fer662/tero-toolhead/exports/cfd/large/walls.stl

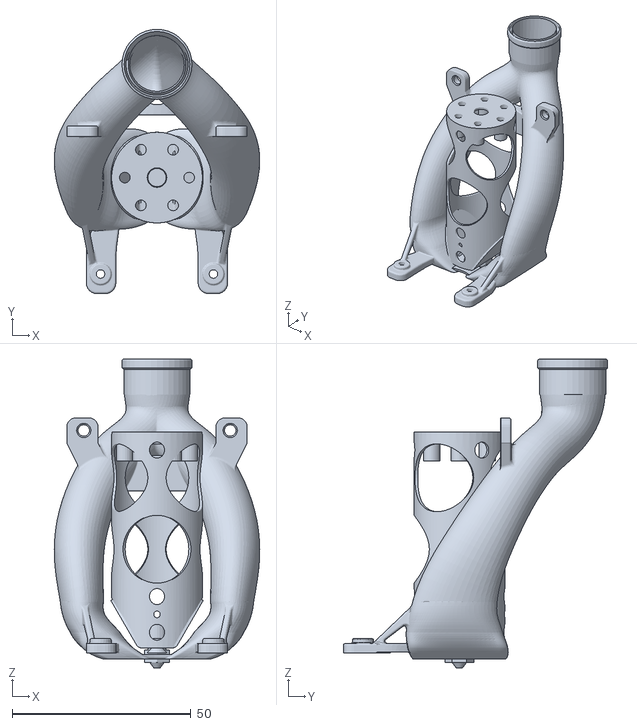
[picture p5: CAD file, 2026-11-13]
exports/cfd/large/walls.stl
57.5 x 74.0 x 86.5
