fer662/tero-toolhead/exports/cfd/small/walls.stl

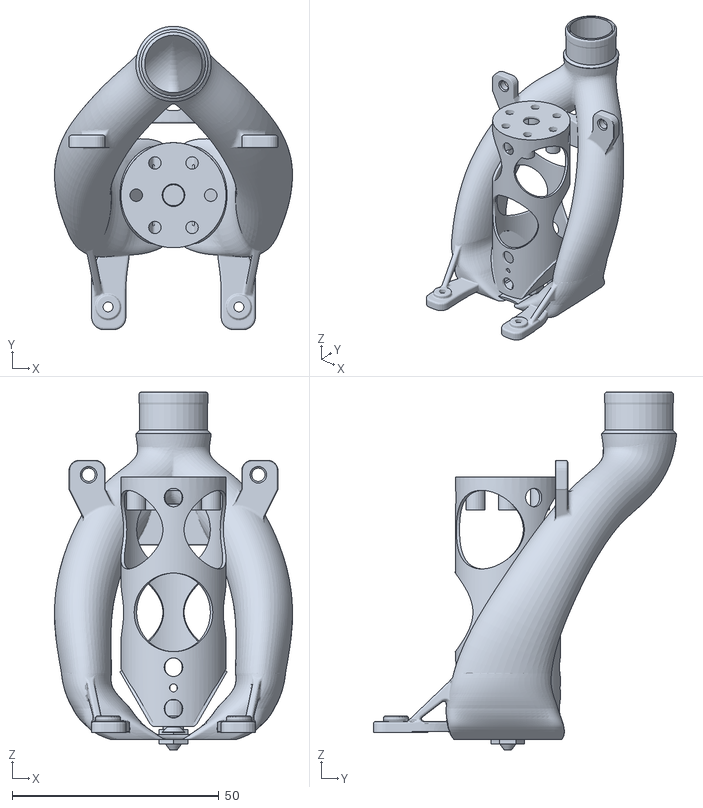
[picture p6: CAD file, 2026-11-13]
exports/cfd/small/walls.stl
57.5 x 73.3 x 86.5
