fer662/tero-toolhead/exports/stl/duct-small.stl

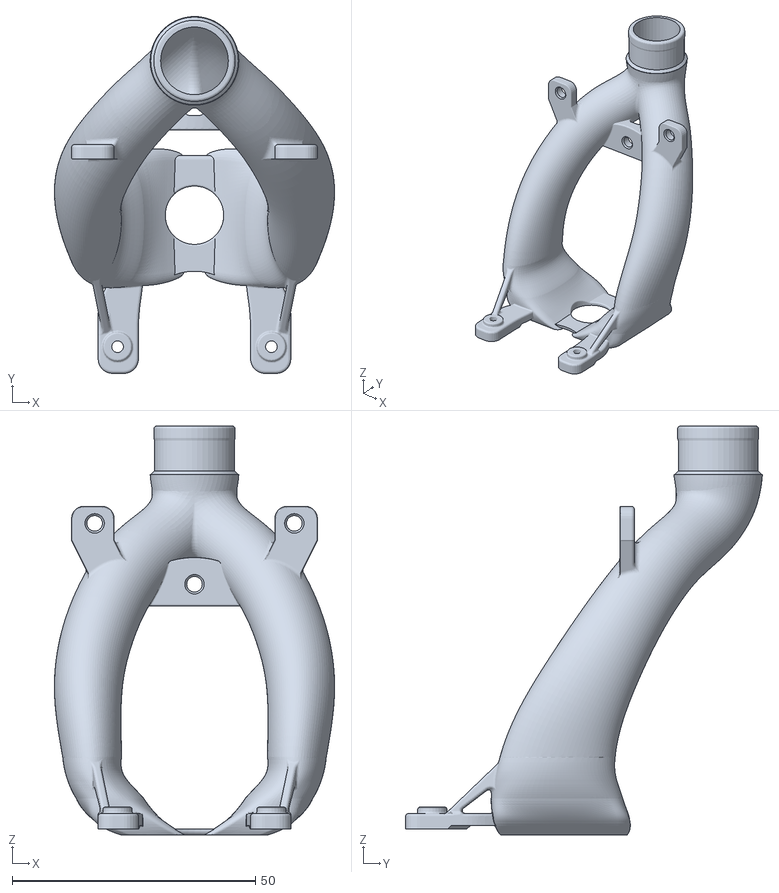
[picture p7: CAD file, 2026-11-13]
exports/stl/duct-small.stl
57.5 x 73.3 x 84.0
