fer662/tero-toolhead/exports/stl/monolith/core.stl

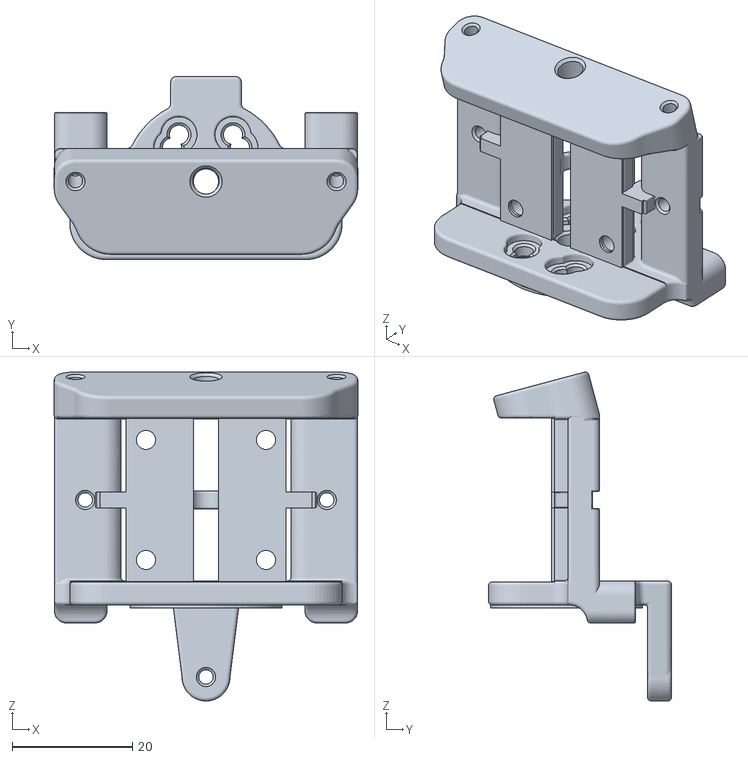
[picture p8: CAD file, 2026-11-13]
exports/stl/monolith/core.stl
50.6 x 30.5 x 54.8
