fer662/tero-toolhead/exports/stl/voron/core.stl

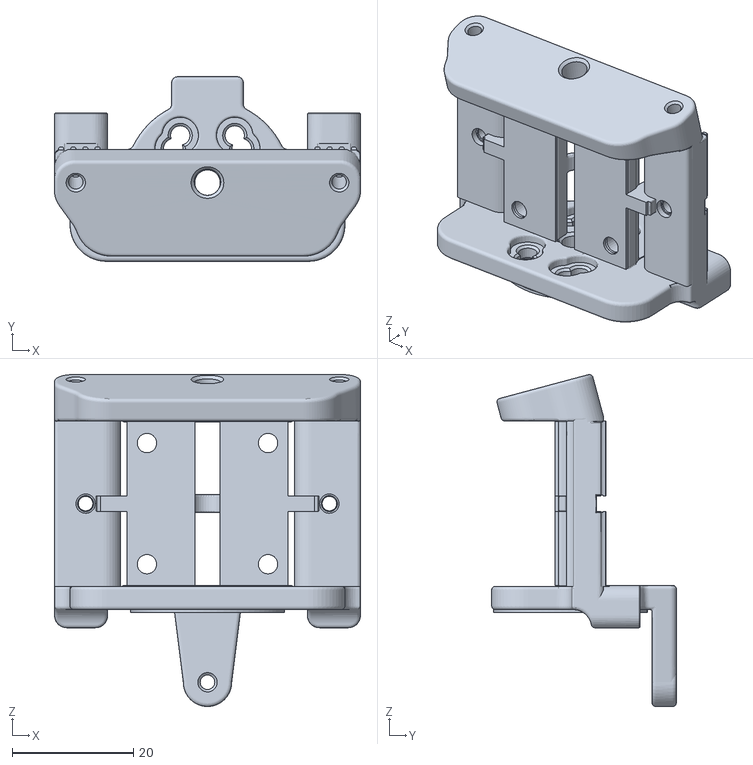
[picture p9: CAD file, 2026-11-13]
exports/stl/voron/core.stl
50.6 x 30.5 x 54.8
