fer662/tero-toolhead/exports/cfd/large/farfield.stl

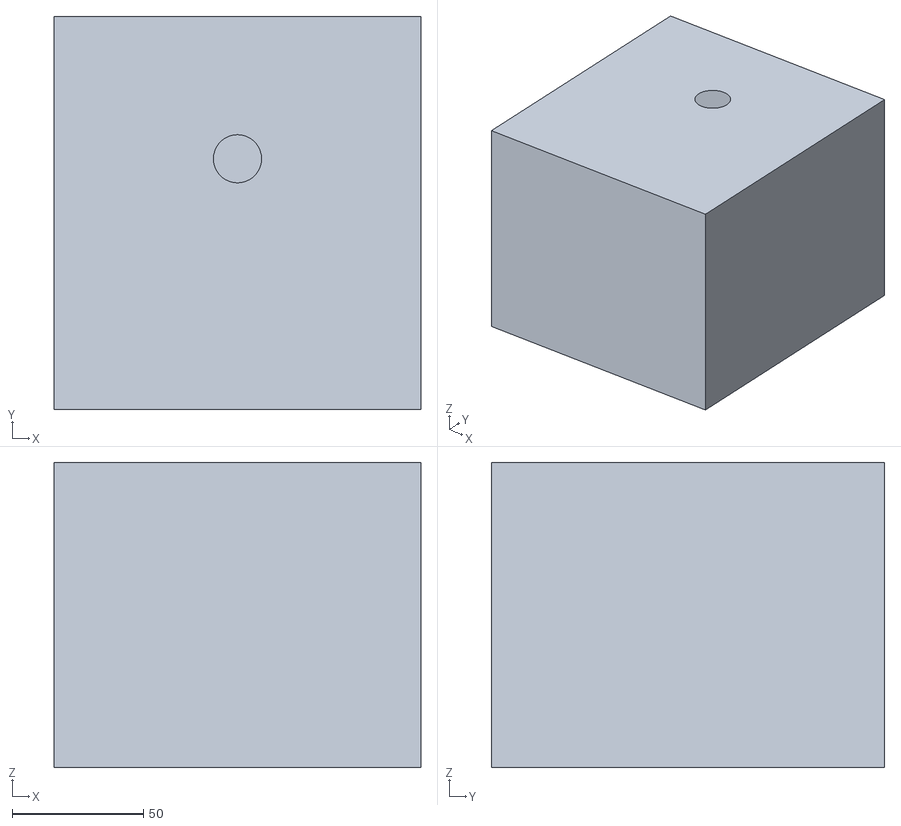
[picture p10: CAD file, 2026-11-07]
exports/cfd/large/farfield.stl
140.0 x 150.0 x 116.5
