fer662/tero-toolhead/exports/cfd/small/inlet.stl

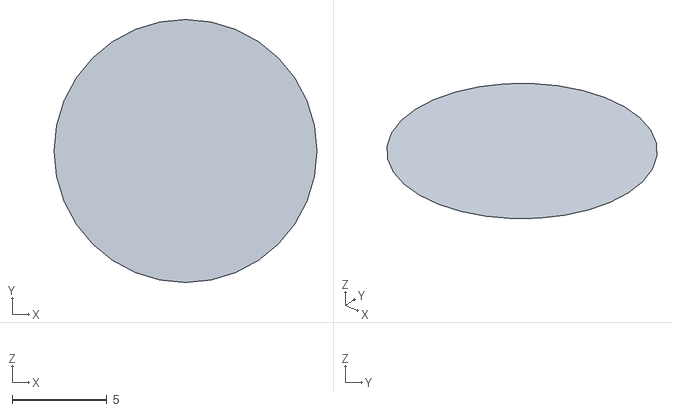
[picture p11: CAD file, 2026-11-07]
exports/cfd/small/inlet.stl
13.9 x 13.9 x 0
