fer662/tero-toolhead/exports/stl/duct-large.stl

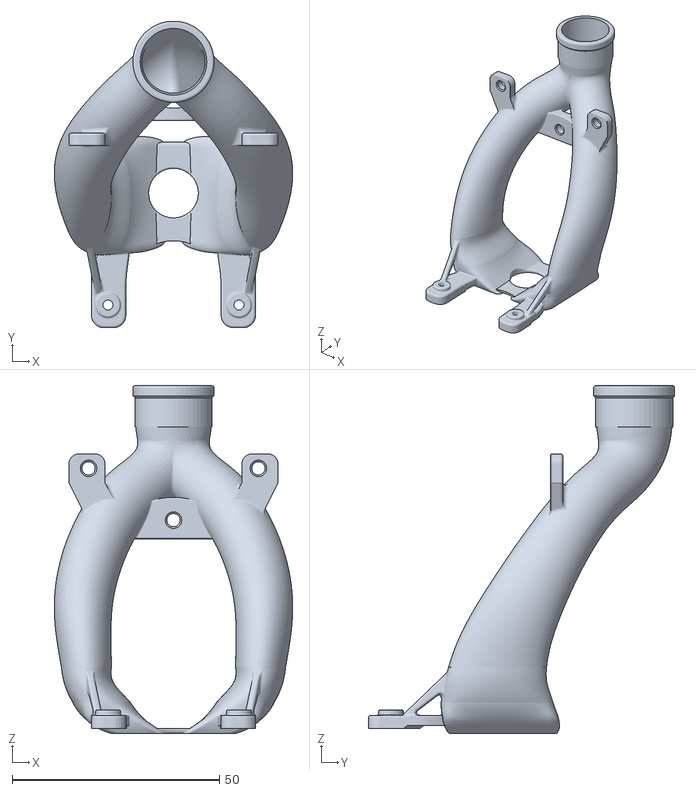
[picture p12: CAD file, 2026-11-13]
exports/stl/duct-large.stl
57.5 x 74.0 x 84.0
