fer662/tero-toolhead/exports/stl/monolith/clips-both.stl

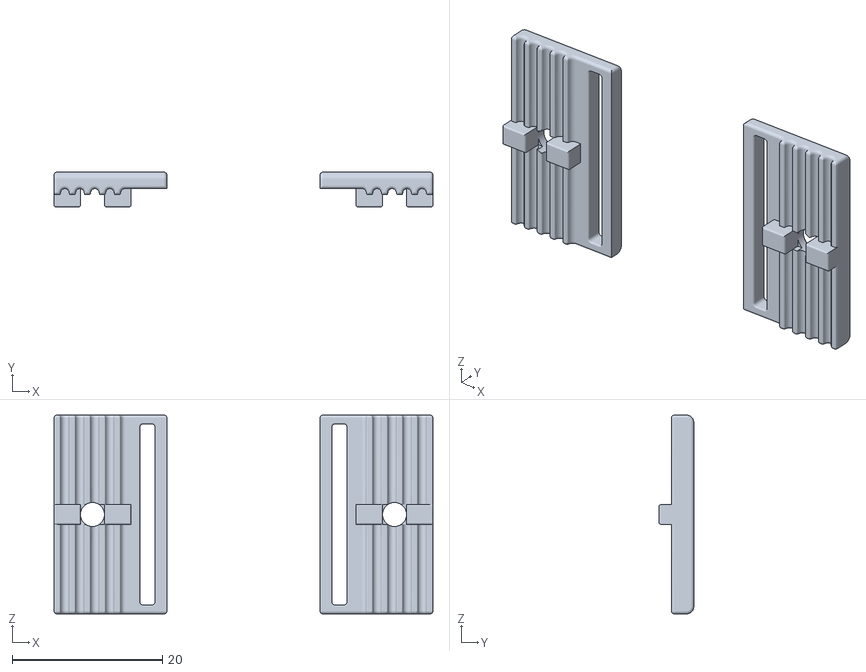
[picture p13: CAD file, 2026-11-08]
exports/stl/monolith/clips-both.stl
50.5 x 4.63 x 26.5
