fer662/tero-toolhead/exports/stl/voron/clips-both.stl

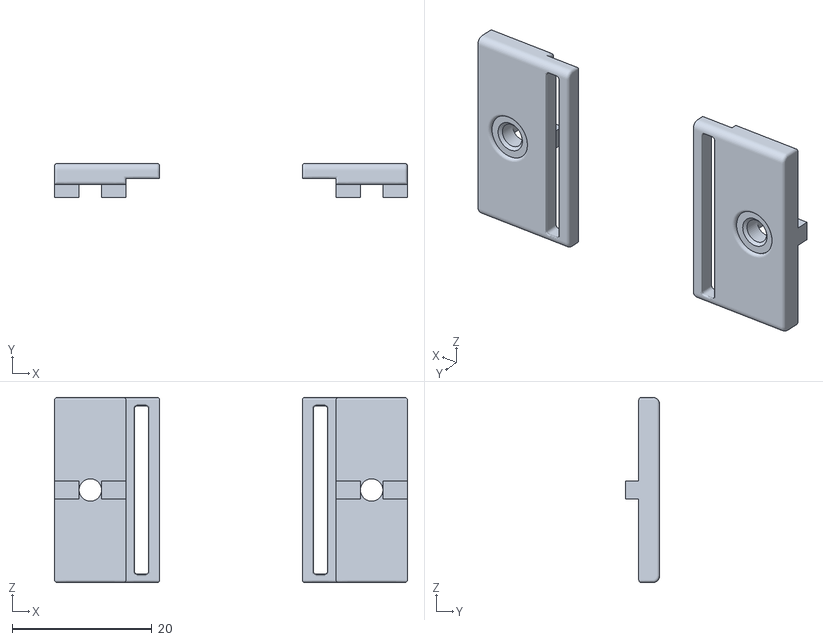
[picture p14: CAD file, 2026-11-09]
exports/stl/voron/clips-both.stl
50.5 x 4.92 x 26.5
