fer662/tero-toolhead/exports/cfd/large/inlet.stl

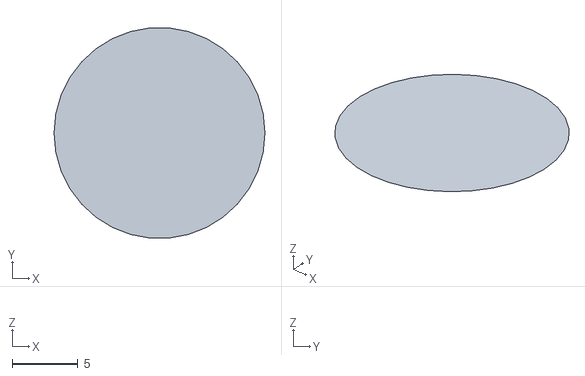
[picture p15: CAD file, 2026-11-07]
exports/cfd/large/inlet.stl
16.1 x 16.0 x 0
