fer662/tero-toolhead/(list of files, cad)

Other CAD files:
exports/cfd/small/farfield.stl
cad/toolhead.f3d
