fer662/tero-toolhead/(commit log)

2026-11-04 initial commit at v1.0-RC8
    [clip-left.stl, clip-right.stl, core.stl, duct-large.stl, duct-small.stl, farfield.stl, inlet.stl, toolhead.f3d]
2026-11-04 removed overhanging part of core that apparently wasn't doing any work
    [clip-right.stl, core.stl, toolhead.f3d]
2026-11-06 chamfer on top and bottom of hotend mounting point 2mm deeper sherpa mini mount holes chamfer on the beacon mounting point
    [clip-right.stl, core.stl, duct-large.stl, duct-small.stl, toolhead.f3d, walls.stl]
2026-11-07 increased depth of side duct mounting holes stronger beacon bracing
    [clip-right.stl, core.stl, duct-large.stl, duct-small.stl, toolhead.f3d, walls.stl]
2026-11-07 added loop around the PTFE tube so it doesn't move around reworked cad to improve timeline. no longer uses any base features for the toolhead parts clips export together
    [clip-left.stl, clip-right.stl, clips-both.stl, core.stl, duct-large.stl, duct-small.stl, farfield.stl, inlet.stl]
2026-11-08 Added belt slack management to the clips Updated screenshots
    [clips-both.stl, core.stl, duct-large.stl, duct-small.stl, toolhead.f3d, walls.stl]
2026-11-08 supporting voron belt path
    [clips-both.stl, core.stl, duct-large.stl, duct-small.stl, toolhead.f3d, walls.stl]
2026-11-09 made room to fit a socket for the nozzle adjusted duct exits
    [core.stl, duct-large.stl, duct-small.stl, toolhead.f3d, walls.stl]
2026-11-09 removed teeth on the back of core for voron belt path
    [core.stl, duct-large.stl, duct-small.stl, toolhead.f3d, walls.stl]
2026-11-09 Fixed unnecessary feature on voron clips
    [clips-both.stl, core.stl, duct-large.stl, duct-small.stl, toolhead.f3d, walls.stl]
2026-11-10 fillets around ptfe loop fillets on core
    [core.stl, duct-large.stl, duct-small.stl, toolhead.f3d, walls.stl]
2026-11-13 added missing fillets
    [core.stl, duct-large.stl, duct-small.stl, toolhead.f3d, walls.stl]
